CatoLynx/36C3-Badge/README.md

# Cato's 36C3 Badge

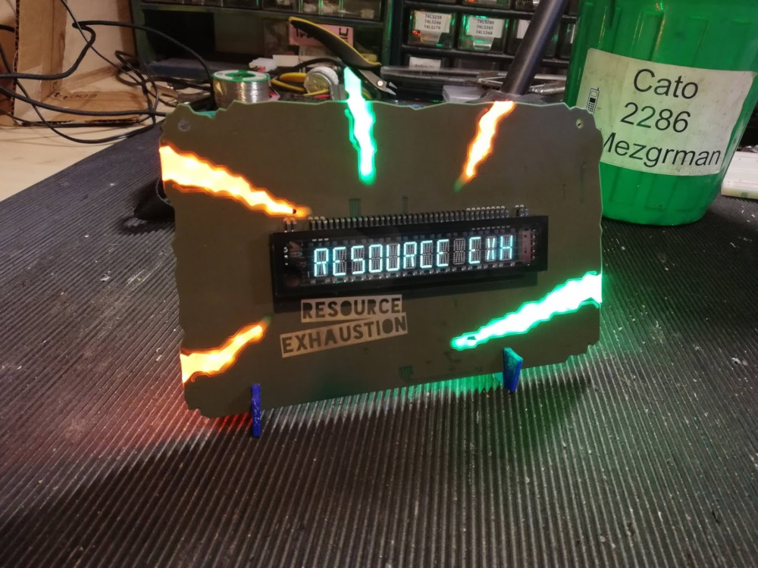
[picture p1: 36C3_Badge_Hardware/Images/badge.jpg]
Front photo


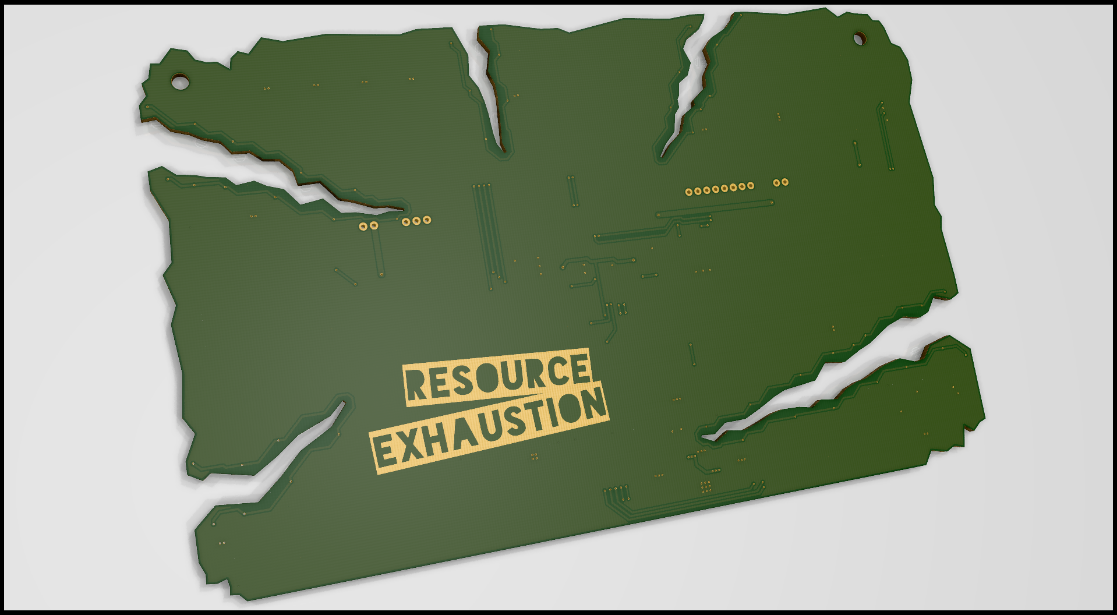
[picture p2: 36C3_Badge_Hardware/Images/3D_Front.png]
Front view


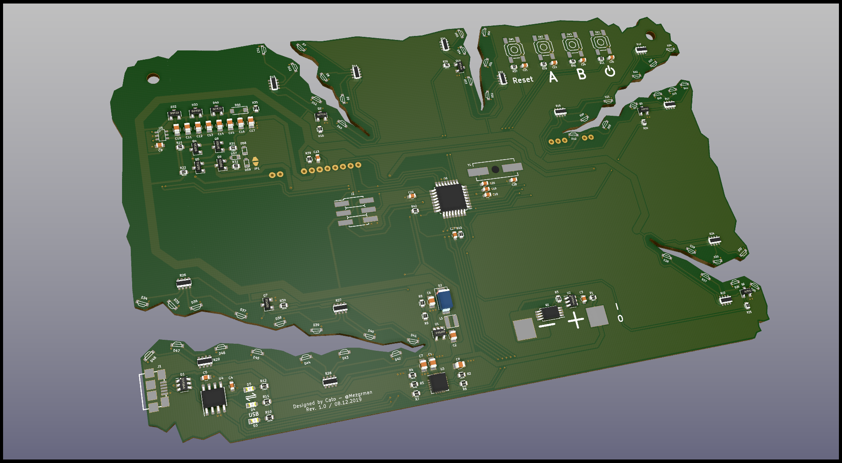
[picture p3: 36C3_Badge_Hardware/Images/3D_Back.png]
Back view
