CatoLynx/36C3-Badge/36C3_Badge_Hardware/CAD/Hope2.SLDPRT

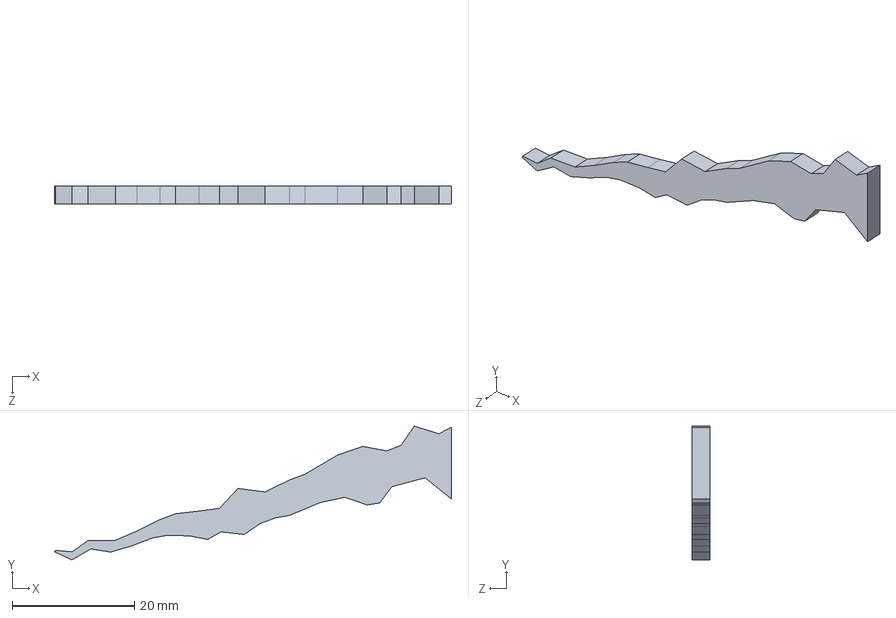
[picture p4: CAD file, 2019-12-22]
36C3_Badge_Hardware/CAD/Hope2.SLDPRT
64.9 x 21.9 x 3.00 mm
