CatoLynx/36C3-Badge/36C3_Badge_Hardware/CAD/Hope1.SLDPRT

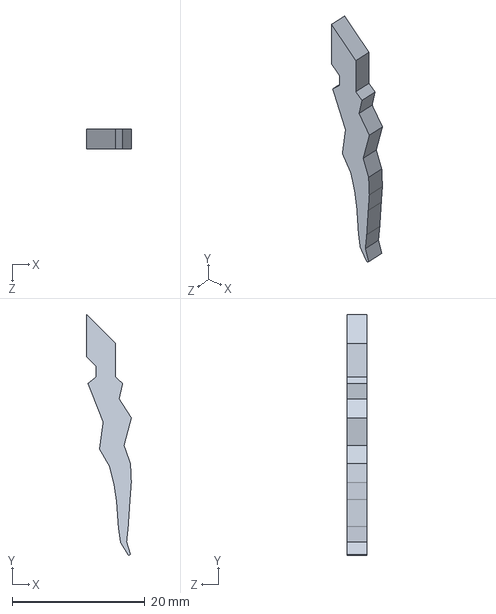
[picture p5: CAD file, 2019-12-15]
36C3_Badge_Hardware/CAD/Hope1.SLDPRT
6.75 x 36.2 x 3.00 mm
