CatoLynx/36C3-Badge/36C3_Badge_Hardware/CAD/Destruction1.SLDPRT

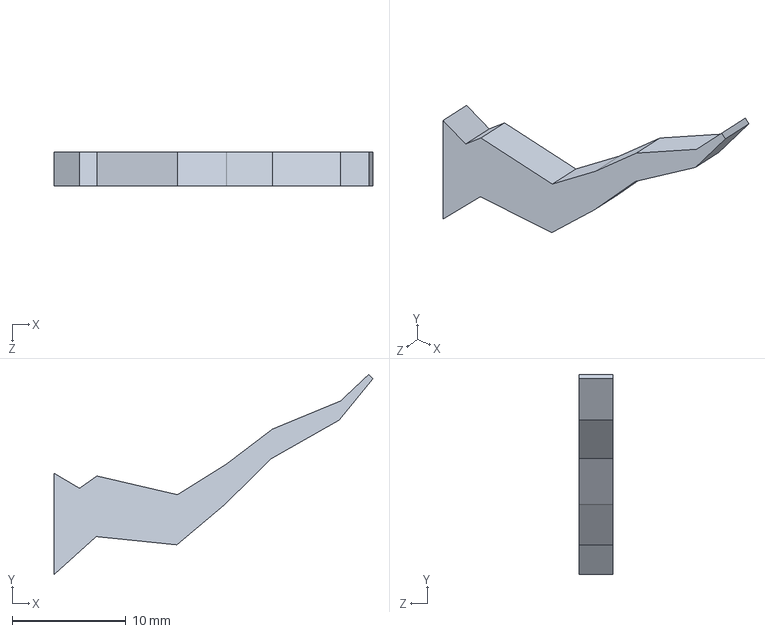
[picture p6: CAD file, 2019-12-15]
36C3_Badge_Hardware/CAD/Destruction1.SLDPRT
28.0 x 17.6 x 3.00 mm
