CatoLynx/36C3-Badge/36C3_Badge_Hardware/CAD/Destruction3.SLDPRT

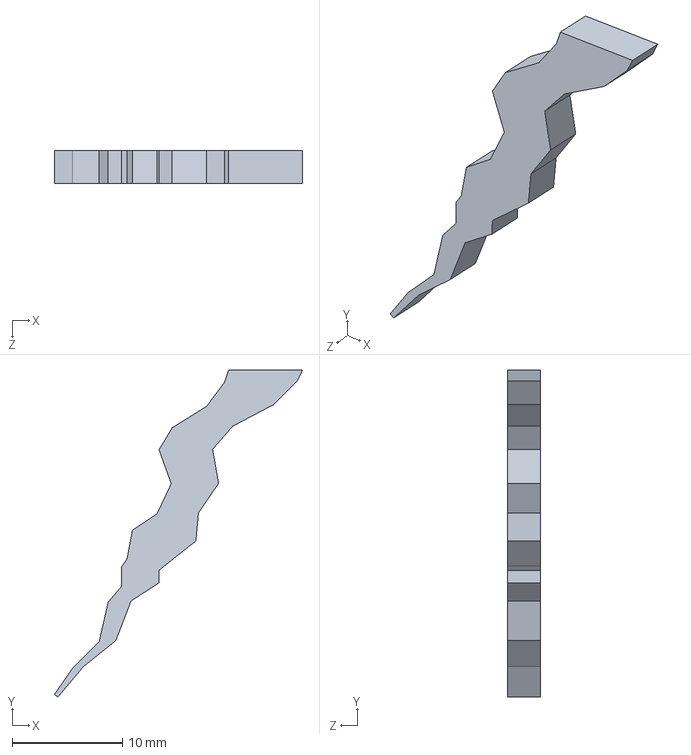
[picture p7: CAD file, 2019-12-15]
36C3_Badge_Hardware/CAD/Destruction3.SLDPRT
22.5 x 29.7 x 3.00 mm
