CatoLynx/36C3-Badge/36C3_Badge_Hardware/CAD/Stand.SLDPRT

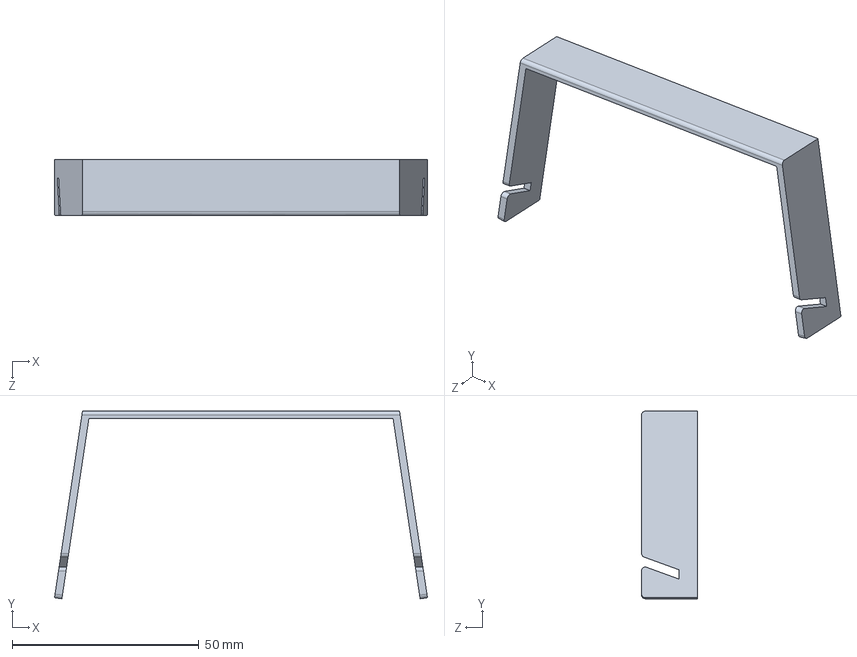
[picture p8: CAD file, 2019-12-15]
36C3_Badge_Hardware/CAD/Stand.SLDPRT
100.0 x 50.3 x 15.0 mm
