CatoLynx/36C3-Badge/36C3_Badge_Hardware/CAD/Destruction2.SLDPRT

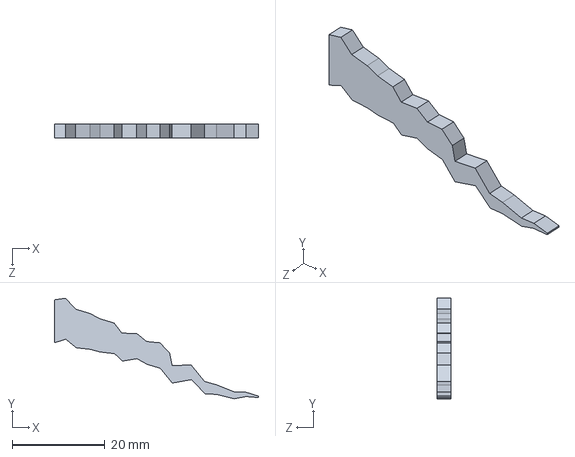
[picture p9: CAD file, 2019-12-15]
36C3_Badge_Hardware/CAD/Destruction2.SLDPRT
43.9 x 21.6 x 3.00 mm
