CatoLynx/36C3-Badge/36C3_Badge_Hardware/CAD/Outline.dxf

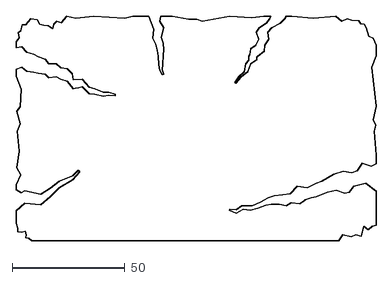
[picture p10: CAD file, 2019-12-06]
36C3_Badge_Hardware/CAD/Outline.dxf
160.0 x 100.0
