CatoLynx/36C3-Badge/(list of files, cad)

Other CAD files:
36C3_Badge_Hardware/CAD/Destruction1.STL
36C3_Badge_Hardware/CAD/Destruction1.dxf
36C3_Badge_Hardware/CAD/Destruction2.STL
36C3_Badge_Hardware/CAD/Destruction2.dxf
36C3_Badge_Hardware/CAD/Destruction3.STL
36C3_Badge_Hardware/CAD/Destruction3.dxf
36C3_Badge_Hardware/CAD/Hope1.STL
36C3_Badge_Hardware/CAD/Hope1.dxf
36C3_Badge_Hardware/CAD/Hope2.STL
36C3_Badge_Hardware/CAD/Hope2.dxf
36C3_Badge_Hardware/CAD/Stand.STL
