CatoLynx/36C3-Badge/36C3_Badge_Hardware/BOM.pdf

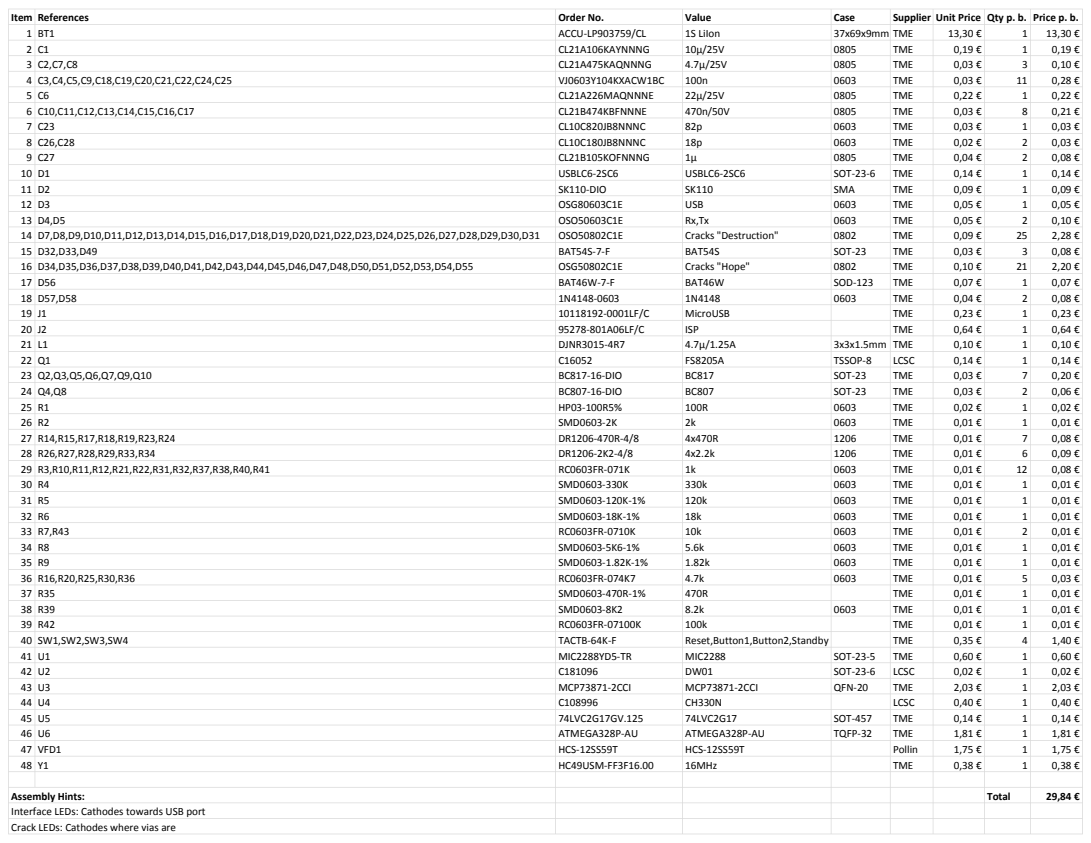
[picture p11: page 1]

Interface LEDs: Cathodes towards USB port
Crack LEDs: Cathodes where vias are
