CatoLynx/36C3-Badge/36C3_Badge_Hardware/36C3_Badge_Hardware.pdf

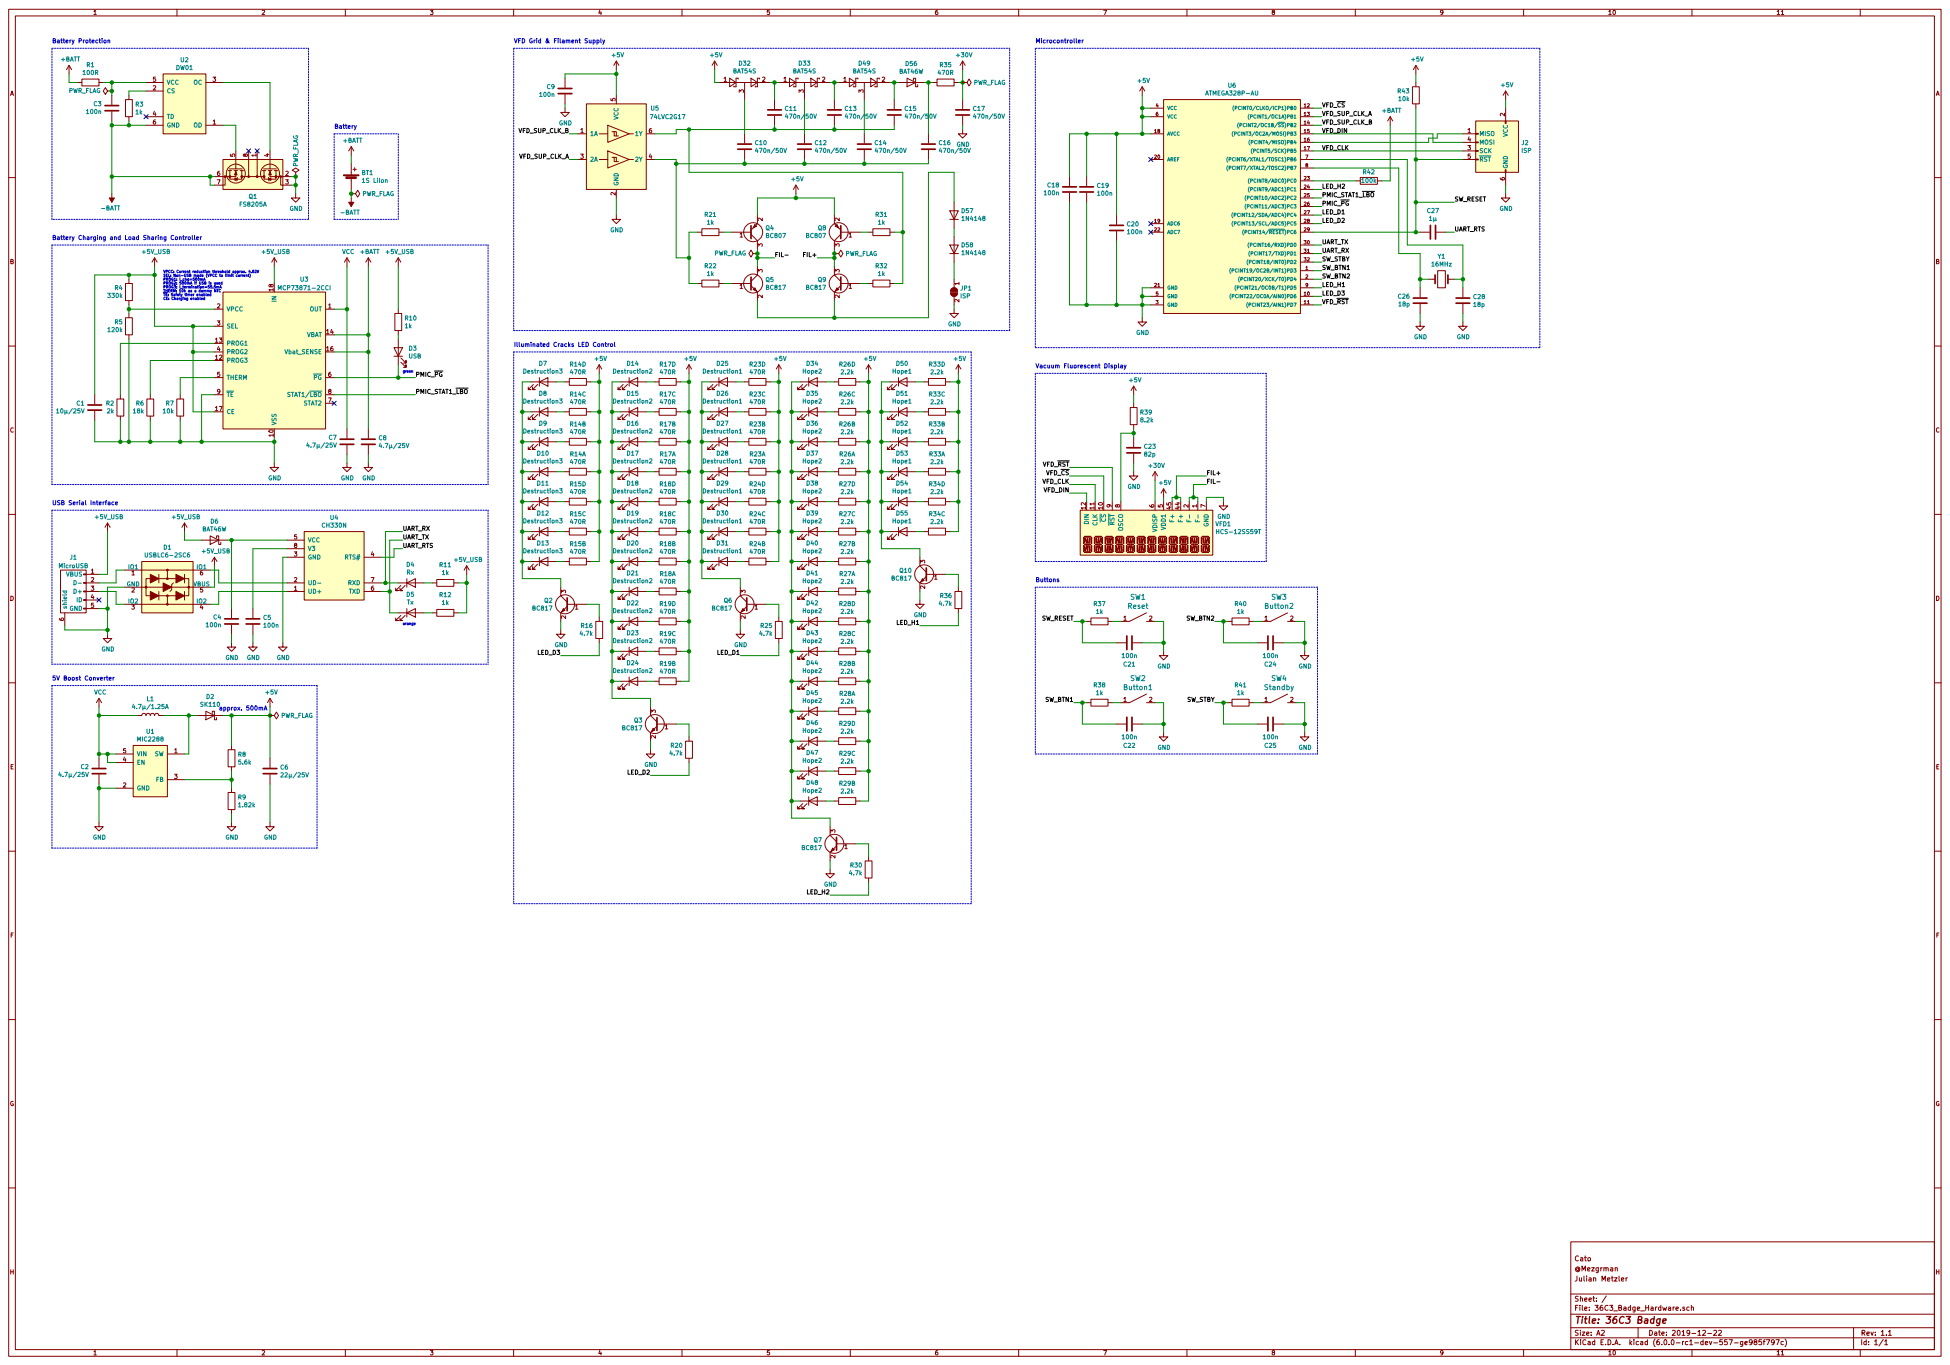
[picture p12: page 1]

8 Q1 FS8205A OD 1 CS 2 OC 3 TD 4 VCC 5 GND 6 U2 DW01 R3

Vacuum Fluorescent Display +5V_USB GND

VPCC: Current reduction threshold approx. 4.62V
SEL: Non-USB mode (VPCC to limit current) PROG1: I_chg=500mA
PROG2: 500mA if USB is used PROG3: I_termination=55.5mA
THERM: 10k as a dummy NTC

2 3 Q6 BC817 GND GND GND GND GND

File: 36C3_Badge_Hardware.sch Sheet: / Julian Metzler @Mezgrman Cato
