CatoLynx/36C3-Badge/36C3_Badge_Hardware/36C3_Badge_Hardware.kicad_pcb

## KiCad design 36C3_Badge_Hardware/36C3_Badge_Hardware.kicad_pcb (2019-12-22)

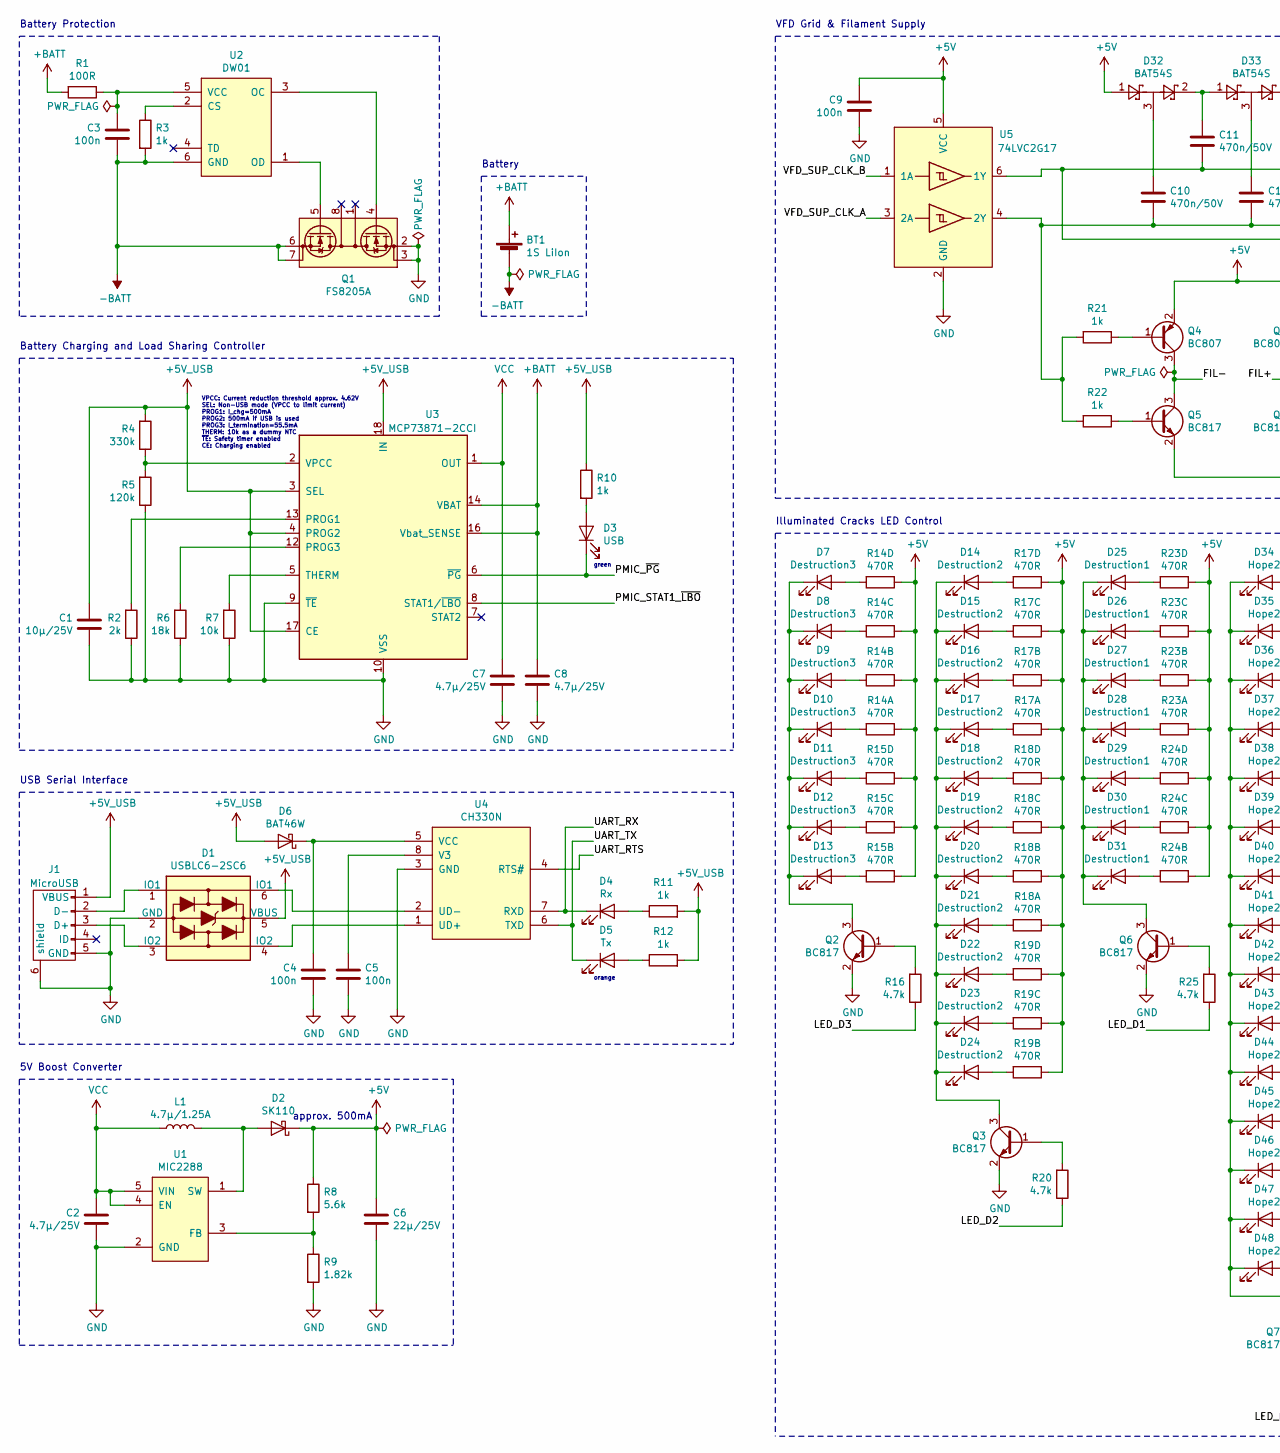
[picture p13: schematic 36C3_Badge_Hardware.sch, 36C3 Badge, part in row 1, column 1]

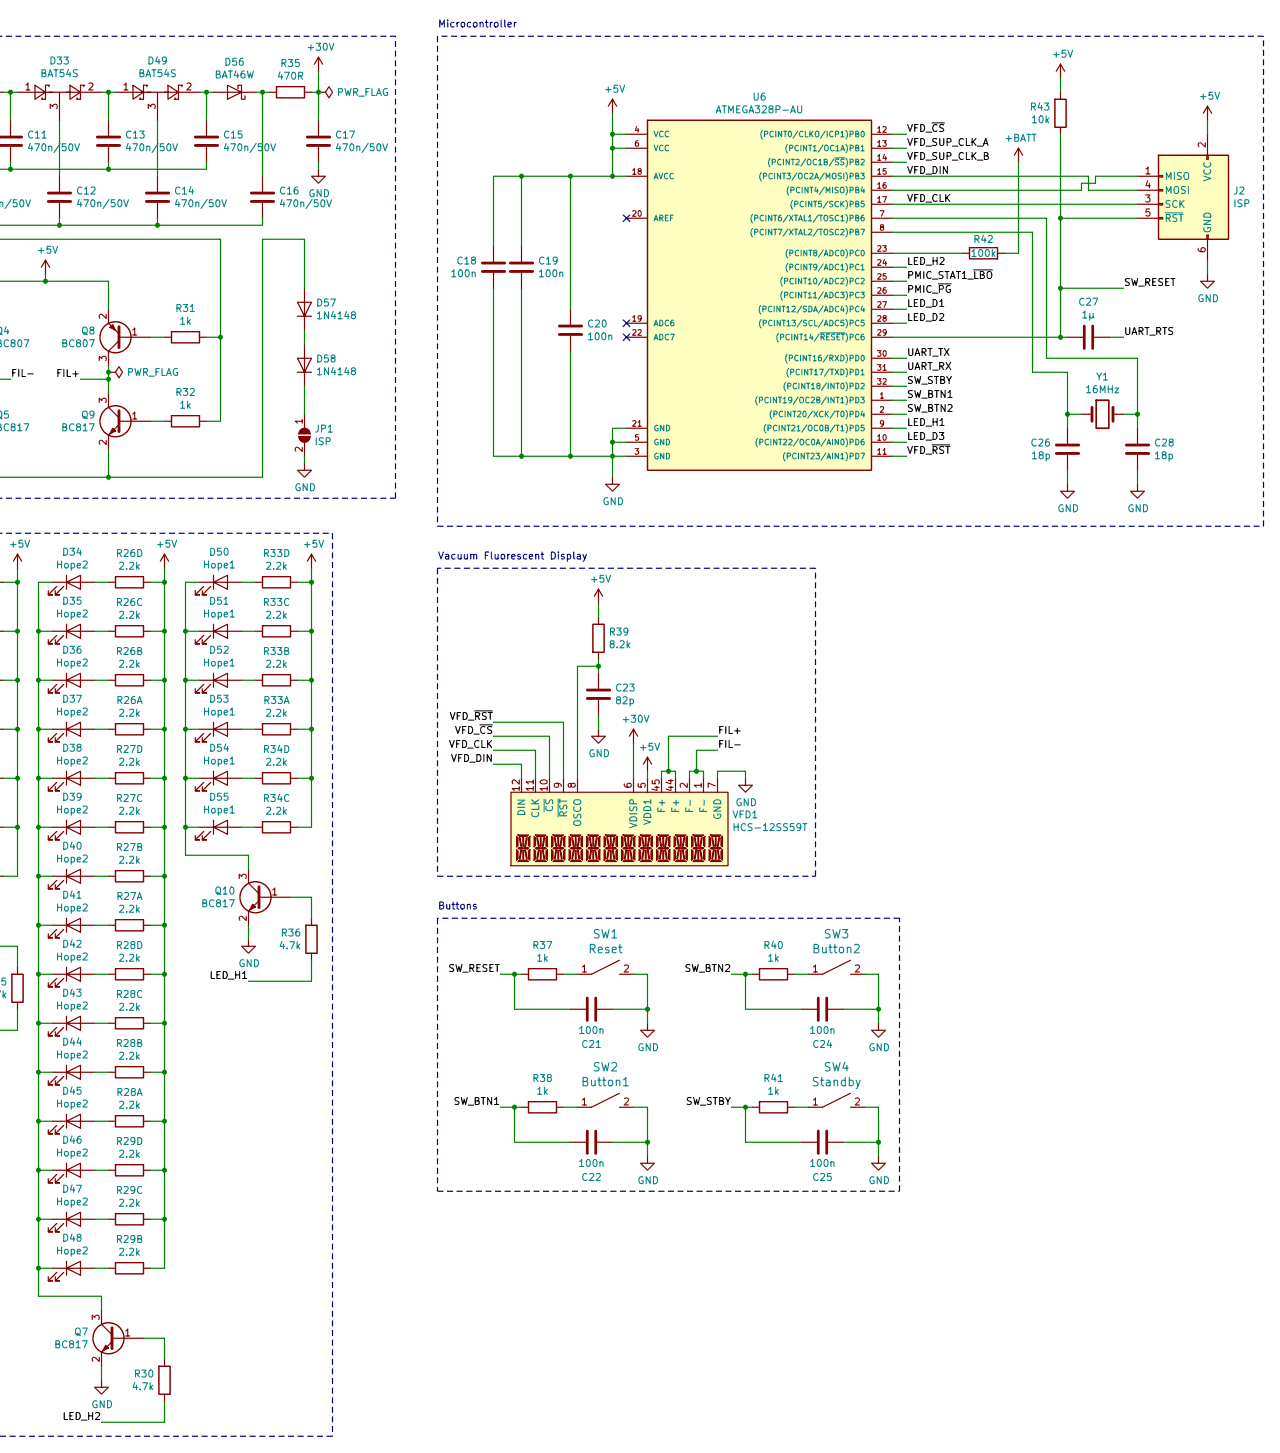
[picture p14: schematic 36C3_Badge_Hardware.sch, 36C3 Badge, part in row 1, column 2]

Parts:
BT1: 1S LiIon; 1S_18650_Holder_with_Spacers
C1: 10µ/25V; C_0805
C2, C7, C8: 4.7µ/25V; C_0805
C3, C4, C5, C9, C18, C19, C20, C21, C22, C24, C25: 100n; C_0603
C6: 22µ/25V; C_0805
C10, C11, C12, C13, C14, C15, C16, C17: 470n/50V; C_0805
C23: 82p; C_0603
C26, C28: 18p; C_0603
C27: 1µ; C_0805
D1: USBLC6-2SC6; SOT-23-6
D2: SK110; D_SMA_Standard
D3: USB; LED_0603
D4: Rx; LED_0603
D5: Tx; LED_0603
D6, D56: BAT46W; D_SOD-123
D7, D8, D9, D10, D11, D12, D13: Destruction3; LED_SideFacing_0802
D14, D15, D16, D17, D18, D19, D20, D21, D22, D23, D24: Destruction2; LED_SideFacing_0802
D25, D26, D27, D28, D29, D30, D31: Destruction1; LED_SideFacing_0802
D32, D33, D49: BAT54S; SOT-23
D34, D35, D36, D37, D38, D39, D40, D41, D42, D43, D44, D45, D46, D47, D48: Hope2; LED_SideFacing_0802
D50, D51, D52, D53, D54, D55: Hope1; LED_SideFacing_0802
D57, D58: 1N4148; D_0603
J1: MicroUSB; MicroUSB_Amphenol_10118192
J2: ISP; Pin_Header_Straight_SMT_02x03
JP1: ISP; Jumper_SolderBridge
L1: 4.7µ/1.25A; Inductor_3x3mm
Q1: FS8205A; TSSOP-8_4.4x3mm_Pitch0.65mm
Q2, Q3, Q5, Q6, Q7, Q9, Q10: BC817; SOT-23
Q4, Q8: BC807; SOT-23
R1: 100R; R_0603
R2: 2k; R_0603
R3, R10, R11, R12, R21, R22, R31, R32, R37, R38, R40, R41: 1k; R_0603
R4: 330k; R_0603
R5: 120k; R_0603
R6: 18k; R_0603
R7, R43: 10k; R_0603
R8: 5.6k; R_0603
R9: 1.82k; R_0603
R14, R15, R17, R18, R19, R23, R24: 470R; R_Array_Concave_4x0603
R16, R20, R25, R30, R36: 4.7k; R_0603
R26, R27, R28, R29, R33, R34: 2.2k; R_Array_Concave_4x0603
R35: 470R; R_0603
R39: 8.2k; R_0603
R42: 100k; R_0603
SW1: Reset; SW_SPST_SKQG
SW2: Button1; SW_SPST_SKQG
SW3: Button2; SW_SPST_SKQG
SW4: Standby; SW_SPST_SKQG
U1: MIC2288; SOT-23-5
U2: DW01; SOT-23-6
U3: MCP73871-2CCI; QFN-20-1EP_4x4mm_Pitch0.5mm
U4: CH330N; SOIC-8_3.9x4.9mm_Pitch1.27mm
U5: 74LVC2G17; SOT-457
U6: ATMEGA328P-AU; TQFP-32_7x7mm_Pitch0.8mm
VFD1: HCS-12SS59T; VFD_HCS-12SS59T_noSilk
Y1: 16MHz; Crystal_HC49-SD_SMD

Connections:
+5V: C6.1, C9.2, C18.2, C19.1, C20.1, D2.1 (K), D32.1, J2.2 (VCC), Q4.2 (E), Q8.2 (E), R8.1, R14.1, R14.2, R14.3, R14.4, R15.2, R15.3, R15.4, R17.1, R17.2, R17.3, R17.4, R18.1, R18.2, R18.3, R18.4, R19.2, R19.3, R19.4, R23.1, R23.2, R23.3, R23.4, R24.2, R24.3, R24.4, R26.1, R26.2, R26.3, R26.4, R27.1, R27.2, R27.3, R27.4, R28.1, R28.2, R28.3, R28.4, R29.2, R29.3, R29.4, R33.1, R33.2, R33.3, R33.4, R34.3, R34.4, R39.1, R43.2, U5.5 (VCC), U6.4 (VCC), U6.6 (VCC), U6.18 (AVCC), VFD1.5 (VDD1)
+5V_USB: C1.2, D1.5 (VBUS), D6.2 (A), J1.1 (VBUS), R4.2, R10.1, R11.2, R12.2, U3.3 (SEL), U3.4 (PROG2), U3.17 (CE), U3.18 (IN), U3.19 (IN)
+30V: C17.1, R35.1, VFD1.6 (VDISP)
+BATT: BT1.1 (+), C8.1, R1.2, R42.2, U3.14 (VBAT), U3.15 (VBAT), U3.16 (Vbat_SENSE)
-BATT: BT1.2 (-), C3.1, Q1.6 (S2), Q1.7 (S2), R3.2, U2.6 (GND)
/FIL+: Q8.3 (C), Q9.3 (C), VFD1.44 (F+), VFD1.45 (F+)
/FIL-: Q4.3 (C), Q5.3 (C), VFD1.1 (F-), VFD1.2 (F-)
/LED_D1: R25.1, U6.27 ((PCINT12/SDA/ADC4)PC4)
/LED_D2: R20.1, U6.28 ((PCINT13/SCL/ADC5)PC5)
/LED_D3: R16.1, U6.10 ((PCINT22/OC0A/AIN0)PD6)
/LED_H1: R36.1, U6.9 ((PCINT21/OC0B/T1)PD5)
/LED_H2: R30.1, U6.24 ((PCINT9/ADC1)PC1)
/PMIC_STAT1_~LBO: U3.8 (STAT1/~LBO~), U6.25 ((PCINT10/ADC2)PC2)
/PMIC_~PG: D3.1 (K), U3.6 (~PG~), U6.26 ((PCINT11/ADC3)PC3)
/SW_BTN1: C22.1, R38.2, U6.1 ((PCINT19/OC2B/INT1)PD3)
/SW_BTN2: C24.1, R40.2, U6.2 ((PCINT20/XCK/T0)PD4)
/SW_RESET: C21.1, C27.2, J2.5 (~RST), R37.2, R43.1, U6.29 ((PCINT14/~RESET~)PC6)
/SW_STBY: C25.1, R41.2, U6.32 ((PCINT18/INT0)PD2)
/UART_RTS: C27.1, U4.4 (RTS#)
/UART_RX: D4.1 (K), U4.7 (RXD), U6.31 ((PCINT17/TXD)PD1)
/UART_TX: D5.1 (K), U4.6 (TXD), U6.30 ((PCINT16/RXD)PD0)
/VFD_CLK: J2.3 (SCK), U6.17 ((PCINT5/SCK)PB5), VFD1.11 (CLK)
/VFD_DIN: J2.4 (MOSI), U6.15 ((PCINT3/OC2A/MOSI)PB3), VFD1.12 (DIN)
/VFD_SUP_CLK_A: U5.3 (2A), U6.13 ((PCINT1/OC1A)PB1)
/VFD_SUP_CLK_B: U5.1 (1A), U6.14 ((PCINT2/OC1B/~SS~)PB2)
/VFD_~CS: U6.12 ((PCINT0/CLKO/ICP1)PB0), VFD1.10 (~CS)
/VFD_~RST: U6.11 ((PCINT23/AIN1)PD7), VFD1.9 (~RST)
GND: C1.1, C2.1, C4.1, C5.2, C6.2, C7.1, C8.2, C9.1, C17.2, C18.1, C19.2, C20.2, C21.2, C22.2, C23.2, C24.2, C25.2, C26.1, C28.2, D1.2 (GND), J1.5 (GND), J1.6 (shield), J2.6 (GND), JP1.2 (B), Q1.2 (S1), Q1.3 (S1), Q2.2 (E), Q3.2 (E), Q6.2 (E), Q7.2 (E), Q10.2 (E), R2.1, R5.1, R6.1, R7.1, R9.2, SW1.2, SW2.2, SW3.2, SW4.2, U1.2 (GND), U3.9 (~TE), U3.10 (VSS), U3.11 (VSS), U3.21 (VSS), U4.3 (GND), U5.2 (GND), U6.3 (GND), U6.5 (GND), U6.21 (GND), VFD1.7 (GND)
unnamed: C3.2, R1.1, U2.5 (VCC)
unnamed: C4.2, D6.1 (K), U4.5 (VCC)
unnamed: C5.1, U4.8 (V3)
unnamed: C10.1, D32.3
unnamed: C10.2, C12.2, C14.2, C16.2, R21.2, R22.2, U5.4 (2Y)
unnamed: C11.1, D32.2, D33.1
unnamed: C11.2, C13.2, C15.2, R31.2, R32.2, U5.6 (1Y)
unnamed: C12.1, D33.3
unnamed: C13.1, D33.2, D49.1
unnamed: C14.1, D49.3
unnamed: C15.1, D49.2, D56.2 (A)
unnamed: C16.1, D56.1 (K), R35.2
unnamed: C23.1, R39.2, VFD1.8 (OSCO)
unnamed: C26.2, U6.8 ((PCINT7/XTAL2/TOSC2)PB7), Y1.1
unnamed: C28.1, U6.7 ((PCINT6/XTAL1/TOSC1)PB6), Y1.2
unnamed: D1.1 (IO1), J1.2 (D-)
unnamed: D1.3 (IO2), J1.3 (D+)
unnamed: D1.4 (IO2), U4.1 (UD+)
unnamed: D1.6 (IO1), U4.2 (UD-)
unnamed: D2.2 (A), L1.2, U1.1 (SW)
unnamed: D3.2 (A), R10.2
unnamed: D4.2 (A), R11.1
unnamed: D5.2 (A), R12.1
unnamed: D7.2 (A), R14.5
unnamed: D8.2 (A), R14.6
unnamed: D9.2 (A), R14.7
unnamed: D7.1 (K), D8.1 (K), D9.1 (K), D10.1 (K), D11.1 (K), D12.1 (K), D13.1 (K), Q2.3 (C)
unnamed: D10.2 (A), R14.8
unnamed: D11.2 (A), R15.5
unnamed: D12.2 (A), R15.6
unnamed: D13.2 (A), R15.7
unnamed: D14.1 (K), D15.1 (K), D16.1 (K), D17.1 (K), D18.1 (K), D19.1 (K), D20.1 (K), D21.1 (K), D22.1 (K), D23.1 (K), D24.1 (K), Q3.3 (C)
unnamed: D14.2 (A), R17.5
unnamed: D15.2 (A), R17.6
unnamed: D16.2 (A), R17.7
unnamed: D17.2 (A), R17.8
unnamed: D18.2 (A), R18.5
unnamed: D19.2 (A), R18.6
unnamed: D20.2 (A), R18.7
unnamed: D21.2 (A), R18.8
unnamed: D22.2 (A), R19.5
unnamed: D23.2 (A), R19.6
unnamed: D24.2 (A), R19.7
unnamed: D25.1 (K), D26.1 (K), D27.1 (K), D28.1 (K), D29.1 (K), D30.1 (K), D31.1 (K), Q6.3 (C)
unnamed: D25.2 (A), R23.5
unnamed: D26.2 (A), R23.6
unnamed: D27.2 (A), R23.7
unnamed: D28.2 (A), R23.8
unnamed: D29.2 (A), R24.5
unnamed: D30.2 (A), R24.6
unnamed: D31.2 (A), R24.7
unnamed: D34.1 (K), D35.1 (K), D36.1 (K), D37.1 (K), D38.1 (K), D39.1 (K), D40.1 (K), D41.1 (K), D42.1 (K), D43.1 (K), D44.1 (K), D45.1 (K), D46.1 (K), D47.1 (K), D48.1 (K), Q7.3 (C)
unnamed: D34.2 (A), R26.5
unnamed: D35.2 (A), R26.6
unnamed: D36.2 (A), R26.7
unnamed: D37.2 (A), R26.8
unnamed: D38.2 (A), R27.5
unnamed: D39.2 (A), R27.6
unnamed: D40.2 (A), R27.7
unnamed: D41.2 (A), R27.8
unnamed: D42.2 (A), R28.5
unnamed: D43.2 (A), R28.6
unnamed: D44.2 (A), R28.7
unnamed: D45.2 (A), R28.8
unnamed: D46.2 (A), R29.5
unnamed: D47.2 (A), R29.6
unnamed: D48.2 (A), R29.7
unnamed: D50.1 (K), D51.1 (K), D52.1 (K), D53.1 (K), D54.1 (K), D55.1 (K), Q10.3 (C)
unnamed: D50.2 (A), R33.5
unnamed: D51.2 (A), R33.6
unnamed: D52.2 (A), R33.7
unnamed: D53.2 (A), R33.8
unnamed: D54.2 (A), R34.5
unnamed: D55.2 (A), R34.6
unnamed: D57.1 (K), D58.2 (A)
unnamed: D57.2 (A), Q5.2 (E), Q9.2 (E)
unnamed: D58.1 (K), JP1.1 (A)
unnamed: J2.1 (MISO), U6.16 ((PCINT4/MISO)PB4)
unnamed: Q1.4 (G1), U2.3 (OC)
unnamed: Q1.5 (G2), U2.1 (OD)
unnamed: Q2.1 (B), R16.2
unnamed: Q3.1 (B), R20.2
unnamed: Q4.1 (B), R21.1
unnamed: Q5.1 (B), R22.1
unnamed: Q6.1 (B), R25.2
unnamed: Q7.1 (B), R30.2
unnamed: Q8.1 (B), R31.1
unnamed: Q9.1 (B), R32.1
unnamed: Q10.1 (B), R36.2
unnamed: R2.2, U3.13 (PROG1)
unnamed: R3.1, U2.2 (CS)
unnamed: R4.1, R5.2, U3.2 (VPCC)
unnamed: R6.2, U3.12 (PROG3)
unnamed: R7.2, U3.5 (THERM)
unnamed: R8.2, R9.1, U1.3 (FB)
unnamed: R37.1, SW1.1
unnamed: R38.1, SW2.1
unnamed: R40.1, SW3.1
unnamed: R41.1, SW4.1
unnamed: R42.1, U6.23 ((PCINT8/ADC0)PC0)
VCC: C2.2, C7.2, L1.1, U1.4 (EN), U1.5 (VIN), U3.1 (OUT), U3.20 (OUT)

Notes on the sheet:
Battery Protection
Battery
orange
USB Serial Interface
approx. 500mA
5V Boost Converter
VFD Grid & Filament Supply
Illuminated Cracks LED Control
Vacuum Fluorescent Display
VPCC: Current reduction threshold approx. 4.62V SEL: Non-USB mode (VPCC to limit current) PROG1: I_chg=500mA PROG2: 500mA if USB is used PROG3: I_termination=55.5mA THERM: 10k as a dummy NTC ~TE~: Safety timer enabled CE: Charging enabled
Battery Charging and Load Sharing Controller
green
Buttons
Microcontroller

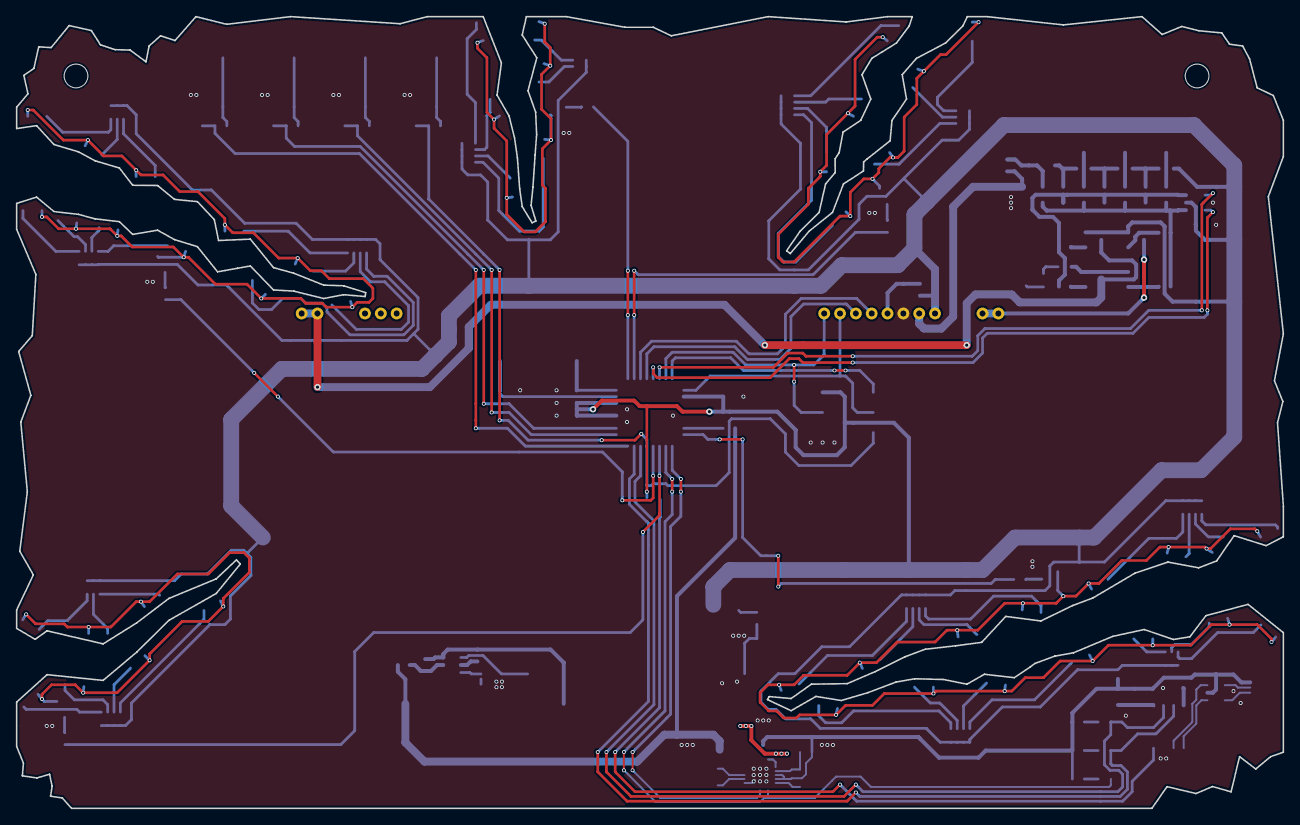
[picture p15: board 36C3_Badge_Hardware.kicad_pcb from above]

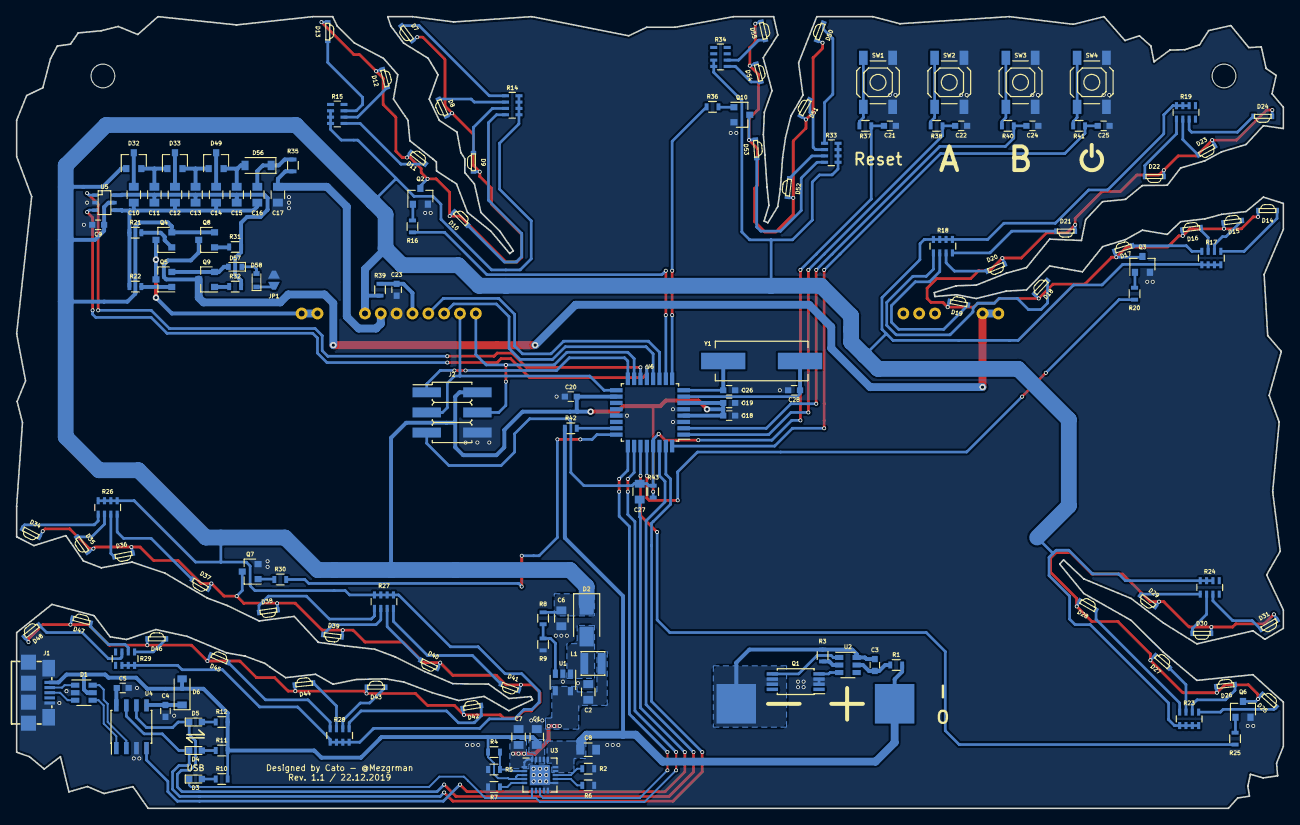
[picture p16: board 36C3_Badge_Hardware.kicad_pcb from below]

Board: 2 copper layers, 160.0 x 100.0 mm, 155 parts (154 on the bottom side), 129 nets.
