CatoLynx/36C3-Badge/36C3_Badge_Software/_36C3_Badge_Software/progmem.h

template <typename T> void PROGMEM_readAnything (const T * sce, T& dest)
{
  memcpy_P (&dest, sce, sizeof (T));
}

template <typename T> T PROGMEM_getAnything (const T * sce)
{
  static T temp;
  memcpy_P (&temp, sce, sizeof (T));
  return temp;
}
