CatoLynx/36C3-Badge/(commit log)

2019-12-06 Initial commit, schematic (hopefully) complete
    [36C3_Badge_Hardware.csv, 36C3_Badge_Hardware.kicad_pcb, 36C3_Badge_Hardware.sch, Destruction1.dxf, Destruction2.dxf, Destruction3.dxf, Hope1.dxf, Hope2.dxf]
2019-12-06 Removed power switch, added footprints
    [36C3_Badge_Hardware.csv, 36C3_Badge_Hardware.sch]
2019-12-06 Rotated pinouts of Q1 and resistor arrays 180° for easier routing
    [36C3_Badge_Hardware.sch]
2019-12-06 Removed D6 (Power LED) since the switch is now gone too
    [36C3_Badge_Hardware.csv, 36C3_Badge_Hardware.sch]
2019-12-06 Fixed incorrect input net to boost converter (was +BATT instead of VCC)
    [36C3_Badge_Hardware.sch]
2019-12-06 Fixed EN of boost converter not being tied to VIN
    [36C3_Badge_Hardware.sch]
2019-12-07 Fixed missing +5V connection to VFD filament H-bridge
    [36C3_Badge_Hardware.sch]
2019-12-07 Updated schematic pdf
    [36C3_Badge_Hardware.sch]
2019-12-08 Swapped some pins on the microcontroller for easier routing
    [36C3_Badge_Hardware.sch]
2019-12-08 Changed VFD footprint to have no silkscreen
    [36C3_Badge_Hardware.sch]
2019-12-08 First revision of PCB
    [36C3_Badge_Hardware-B.Cu.gbr, 36C3_Badge_Hardware-B.Mask.gbr, 36C3_Badge_Hardware-B.Paste.gbr, 36C3_Badge_Hardware-B.SilkS.gbr, 36C3_Badge_Hardware-Edge.Cuts.gbr, 36C3_Badge_Hardware-F.Cu.gbr, 36C3_Badge_Hardware-F.Mask.gbr, 36C3_Badge_Hardware-NPTH.drl]
2019-12-15 Added CAD files
    [Destruction1.SLDPRT, Destruction1.STL, Destruction2.SLDPRT, Destruction2.STL, Destruction3.SLDPRT, Destruction3.STL, Hope1.SLDPRT, Hope1.STL]
2019-12-16 Tidied up code, implemented 6 bit software PWM for the illuminated cracks
    [_36C3_Badge_Software.ino, badge.cpp, badge.h]
2019-12-17 Added custom char generation and battery readout
2019-12-17 Added button input and sleep mode
2019-12-17 Added functions for querying power status
2019-12-17 Added charging breathing animation
2019-12-22 Schematic / Board updates and bugfixes:
    - Updated crack LED resistor values after testing
    - Changed microcontroller reset capacitor from 100nF to 1µF and case from 0603 to 0805
    - Changed MMBTA type transistors to BC types (MMBTA didn't work in the VFD filament H-Bridge)
    - Added Schottky diode in series to CH330 VCC pin. This fixes an error where the badge would erroneously detect USB power when the CH330 was backfed via the high Tx pin.
    [36C3_Badge_Hardware-B.Cu.gbr, 36C3_Badge_Hardware-B.Mask.gbr, 36C3_Badge_Hardware-B.Paste.gbr, 36C3_Badge_Hardware-B.SilkS.gbr, 36C3_Badge_Hardware-Edge.Cuts.gbr, 36C3_Badge_Hardware-F.Cu.gbr, 36C3_Badge_Hardware-F.Mask.gbr, 36C3_Badge_Hardware-NPTH.drl]
2019-12-22 Updated Hope2 crack insert
    [Hope2.SLDPRT, Hope2.STL, Hope2.dxf]
2019-12-23 Multiple changes:
    - Added configurable and selectable text animation setups (defined in config.h)
    - Changed VFD scroll interval from 100 to 10 ms
    - Added function to get battery level in percent (assuming cutoff at 3.0V)
2019-12-23 VFD animations now timer-based, added new options to VFD text list
2019-12-23 Added BOM
2019-12-29 Added power error check to detect a not-yet-known design error
    [_36C3_Badge_Software.ino, badge.cpp, badge.h]
